EdwinKestler/2GWaterMeter/HArdware_Skecthup/README.md

# Moved

The SketchUp model now lives at [`../hardware/cad/Proyecto EmpaguaV3.skp`](../hardware/cad/Proyecto%20EmpaguaV3.skp).

This directory name was kept as a pointer so old paths and the workspace root still resolve.
