EdwinKestler/2GWaterMeter/hardware/cad/exports/README.md

# CAD exports

Put SketchUp-exported `*.stl` / `*.step` here after opening `../Proyecto EmpaguaV3.skp`. See `../README.md` for why this folder is empty: the 2014 SketchUp file cannot be converted in this environment.
