EdwinKestler/2GWaterMeter/docs/Waterbox.pdf

2 de octubre de 2017 [BUSSINESS PLAN]

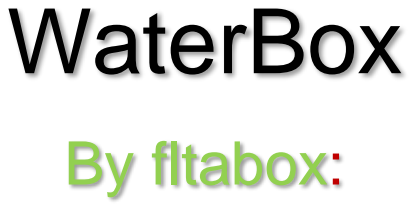
[picture p26: figure]
WaterBox; By fltabox:
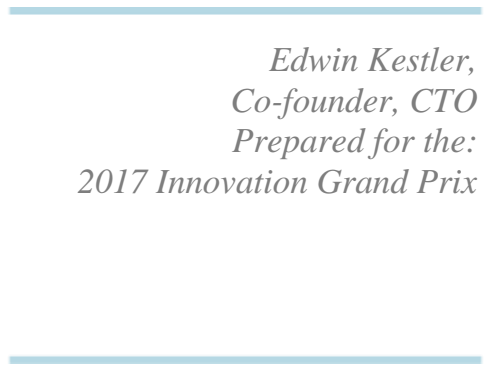
[picture p27: figure]
Edwin Kestler, Co-founder, CTO Prepared for the: 2017 Innovation Grand Prix

Flatbox, S.A | Porject: Waterbox

Flatbox, S.A | Porject: Waterbox

# index

1. Our Company
2. WaterBox
3. Why Private Utility Companies
4. Why B2B as Bussiness model
5. Estrategias de comunicación
6. Embalaje y realización
7. Estrategias de lanzamiento
8. Relaciones Públicas
9. Publicidad
10.Otras actividades promocionales 11.Precios
12.Distribución
13.Mercados
14.Mercados Internacionales 15.Indicadores de éxito
16.Calendario

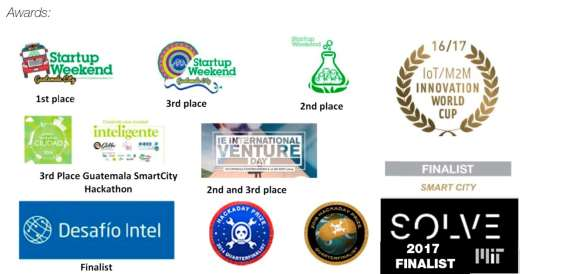
[picture p28: figure]

Flatbox, S.A | Porject: Waterbox

## Our Company

Flatbox,S.A was officially born in Sept 2015 from a group of technological enthusiasts that found a gap between how we experience our world in reality and how we represent those experiences via online data, this gap becomes most significant when using data to replicate or forecast any Bussiness process since physical world data is often incomplete, un reliable or not present at all, hence relevant insights cannot be inferred by software due to this gap in data, we fix this by building and deploying IoT enabled devices that can fill this data gap with sensor data from the conditions surrounding the business process in order to present the most relevant insights we can. As it oct 2017 we have provided solutions for various industries from Access control, via a smart bracelet and reader (15,000+ users) to Utilities with a smart water meter driven by AI (waterbox) to helatcare with a smart emergency attendace boton wich keeps Real World quality od service KPIS via RFID identification cards. (100+ devices Deployed), winning several awards including being finalist at the World mobile congress in Barcelona and MiT Solve Challenge Finalist in New York City.

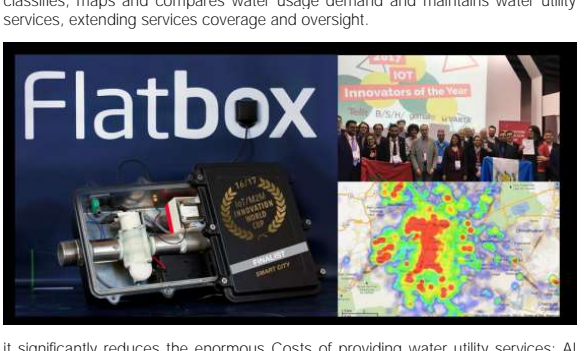
[picture p29: figure]
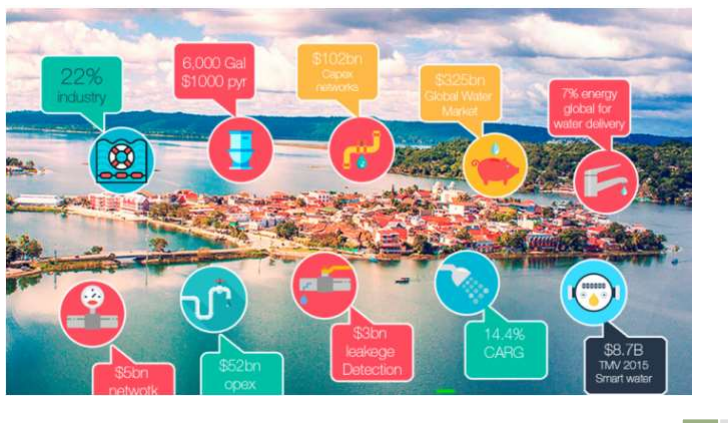
[picture p30: figure]

Flatbox, S.A | Porject: Waterbox

## WaterBox

Waterbox is a 2G IoT, AI managed autonomous Water Meter, it acquired, classifies, maps and compares water usage demand and maintains water utility services, extending services coverage and oversight.

it significantly reduces the enormous Costs of providing water utility services; AI handles data acquired, classifies, maps and compares water usage demand, assigns billing profiles, uses machine learning to maintain the service, autonomously analyzing sensor data a self-recharging mechanism, pressure, tamper and other sensors prevent water fraud and report potential problems such as leaks in the network without human supervision and its cost;

Designed to meet demands for House hold, Small and Medium Business Utilities it enables new pricing models and payment (SMS,Mobile, POS) to be introduced, such as PAYG, prepaid, and other for low income or remote rural areas.

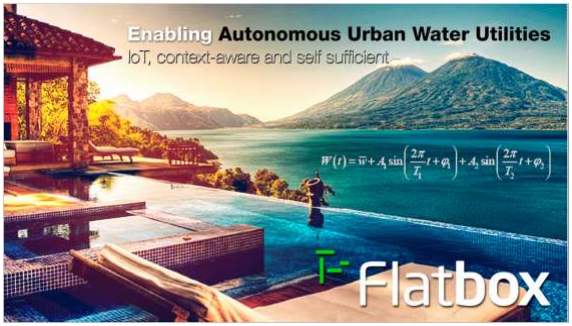
[picture p31: figure]

Flatbox, S.A | Porject: Waterbox

## Watch our pitch @World Mobile Congress 2017:

https://www.youtube.com/watch?v=Ffp5oGQv2uI

it significantly reduces the enormous Costs of providing water utility services; AI handles data acquired, classifies, maps and compares water usage demand, assigns billing profiles, uses machine learning to maintain the service, autonomously analyzing sensor data a self-recharging mechanism,pressure, tamper and other sensors prevent water fraud and report potential problems such as leaks in the network without human supervision and its cost; Designed to meet demands for House hold, Small and Medium Business Utilities it enables new pricing models and payment (SMS,Mobile, POS) to be introduced, such as

PAYG, prepaid, and other for low income or remote rural areas. Bringing transparency, control and flexibility of consumption to utility services increased increased 15% of reliability of utility services and Better water management and monitoring results in a better usage of the resource service preventing scarcity and misuse, providing transparency and efficiency in the utility service, deployment will be done by user adoption (purchase) of the devices driven by reduced water fees incentives via reduction on first water usage data.

It also gives Utility services a way to actively engage service users into

conservation plans such as alert Emails and SMS on misuse, over use or Threshold, every meter generates a water usage signature from machine learning
which is compared continuously to ensure | on service are met and I
incase of severe modification autonomous actions can be taken by the meter in order to prevent significant losses of the resource due to faults or client missuses.

so far we have been granted seed funds from a nonrefundable grant price from a local NGO by the embassy of Taiwan; have a functioning and tested prototype and already have a letter of intent by a private water utility service provider for deploying a 1000 household solution in a 15 year bid to install them in el Fiscal community outside of Guatemala city; to deploy our pilot program a $USD150,000 investment is still needed, upon completion of first pilot program we plan on seeking funding from investors to expand the services in urban areas of Guatemala (private gated house compounds) about 1Million households in Guatemala and from there make the project self-sufficient to expand to rural areas, and seeking VC funds for international growth (about 18 month plan)

The factors limiting our success:

The actual make of the device, as any other IoT project the actual front cost of making the devices is our major growth limit, as it for now our device has a net cost $USD100; as increasing numbers changes costs and time tables for delivery of the devices, making, shipping and delivering the devices is our biggest logistics challenge.
How long we have been working on our solution:
1 year
How long it will take to develop a pilot:
3-6 months
How long it will take to scale beyond our pilot: 6-12 months
Our expected annual budget:
$150000
How much of our budget we've secured to date: $50000

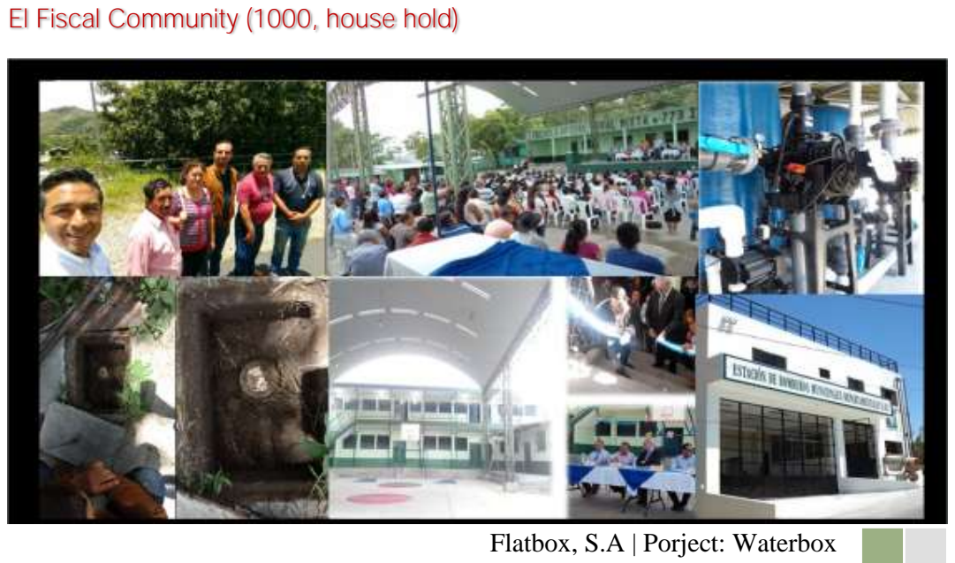
[picture p32: figure]
Flatbox, S.A | Porject: Waterbox; El Fiscal Community (1000, house hold)
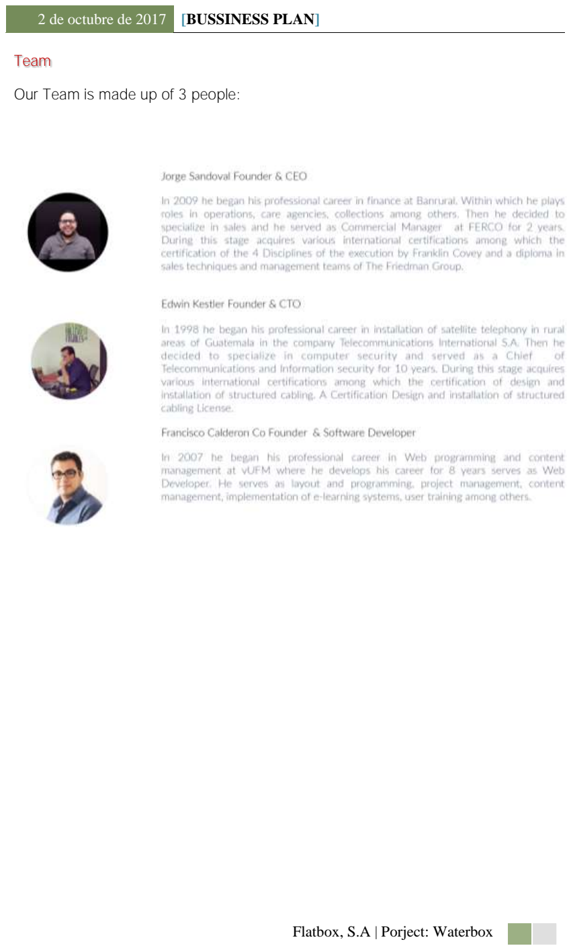
[picture p33: page 7]

Flatbox, S.A | Porject: Waterbox

Team

Our Team is made up of 3 people:

Flatbox, S.A | Porject: Waterbox

## Calendario

Señale el cronograma de actividades en los primeros 12 meses.
