EdwinKestler/2GWaterMeter/docs/WaterBox-EdwinKestler-09-06-2017.pdf

## Enabling, Autonomous Urban Water Utilities

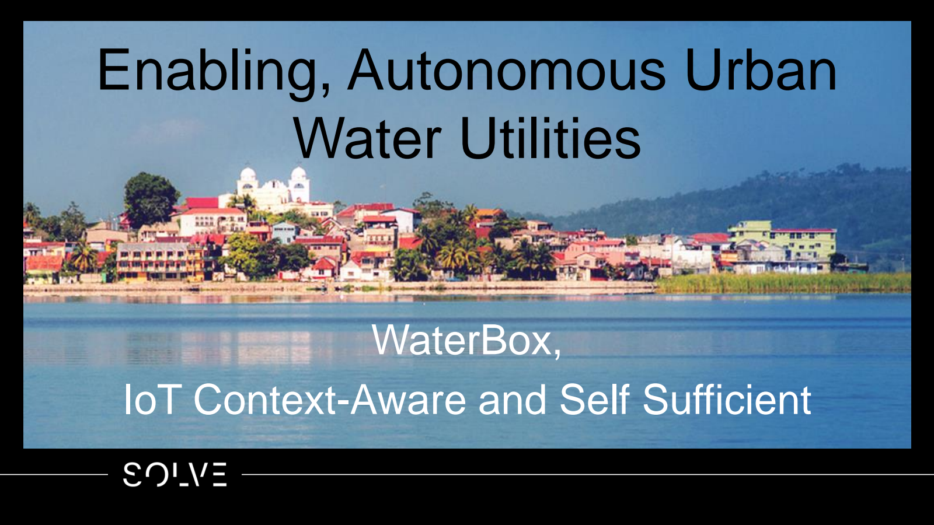
[picture p34: page 1]

WaterBox,
IoT Context-Aware and Self Sufficient

## Great Slides Don’t Need Words

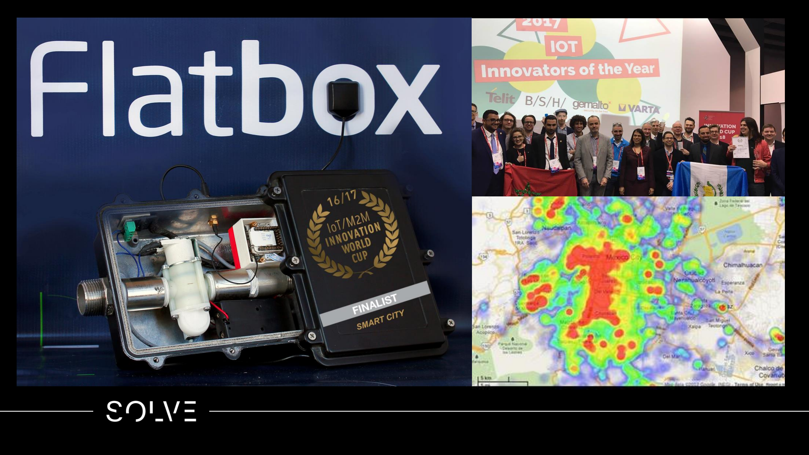
[picture p35: page 2]

Full-page images are very impactful (see next slide).

People understand that images represent what you’re saying; there is no need to describe the images.

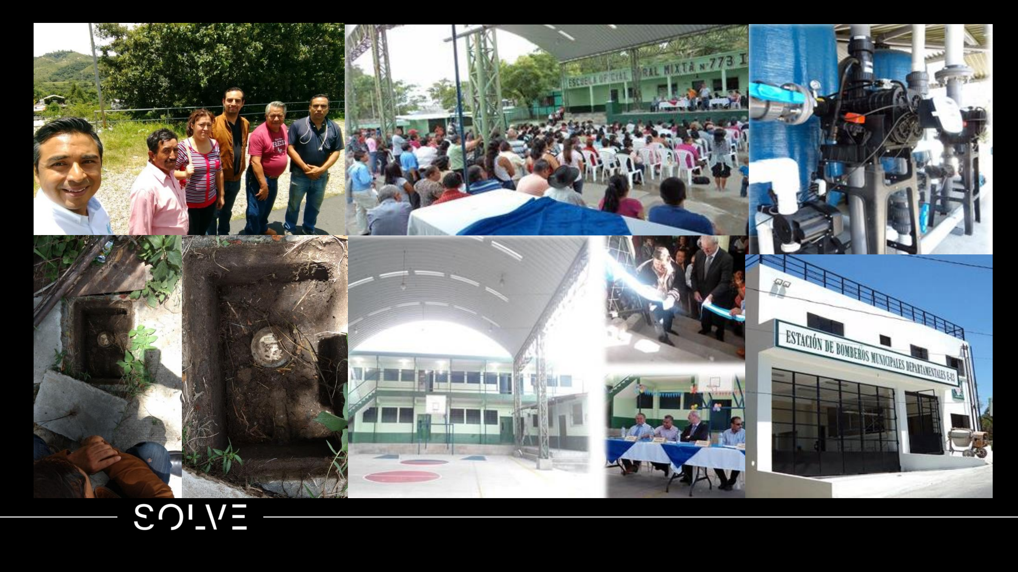
[picture p36: page 3]
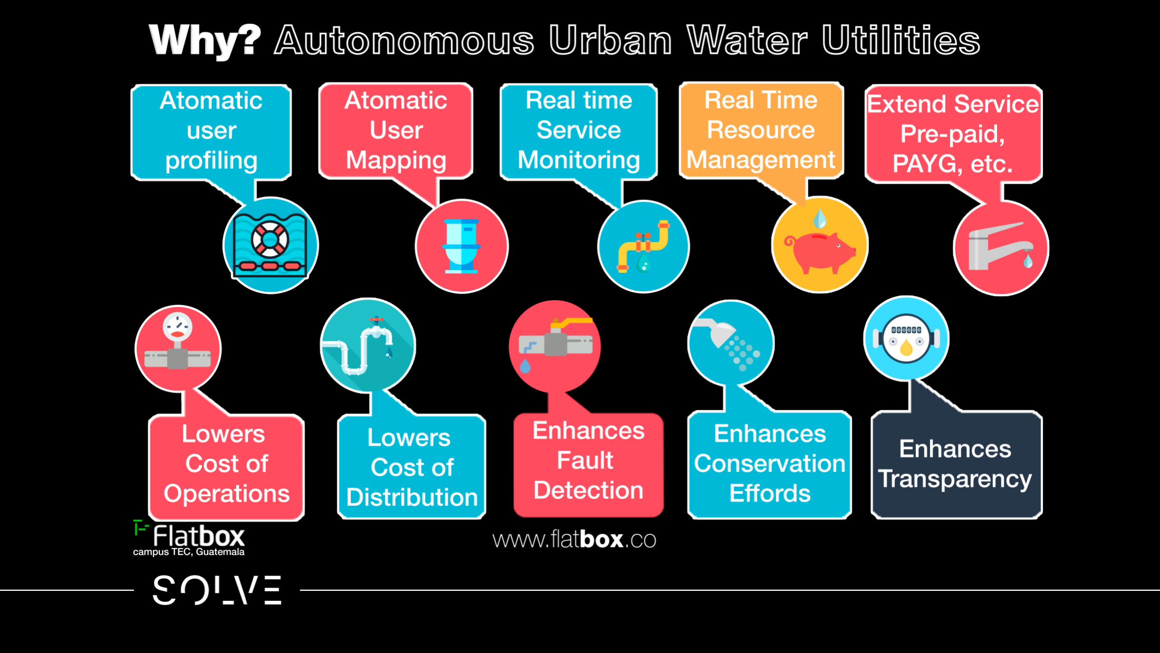
[picture p37: page 4]
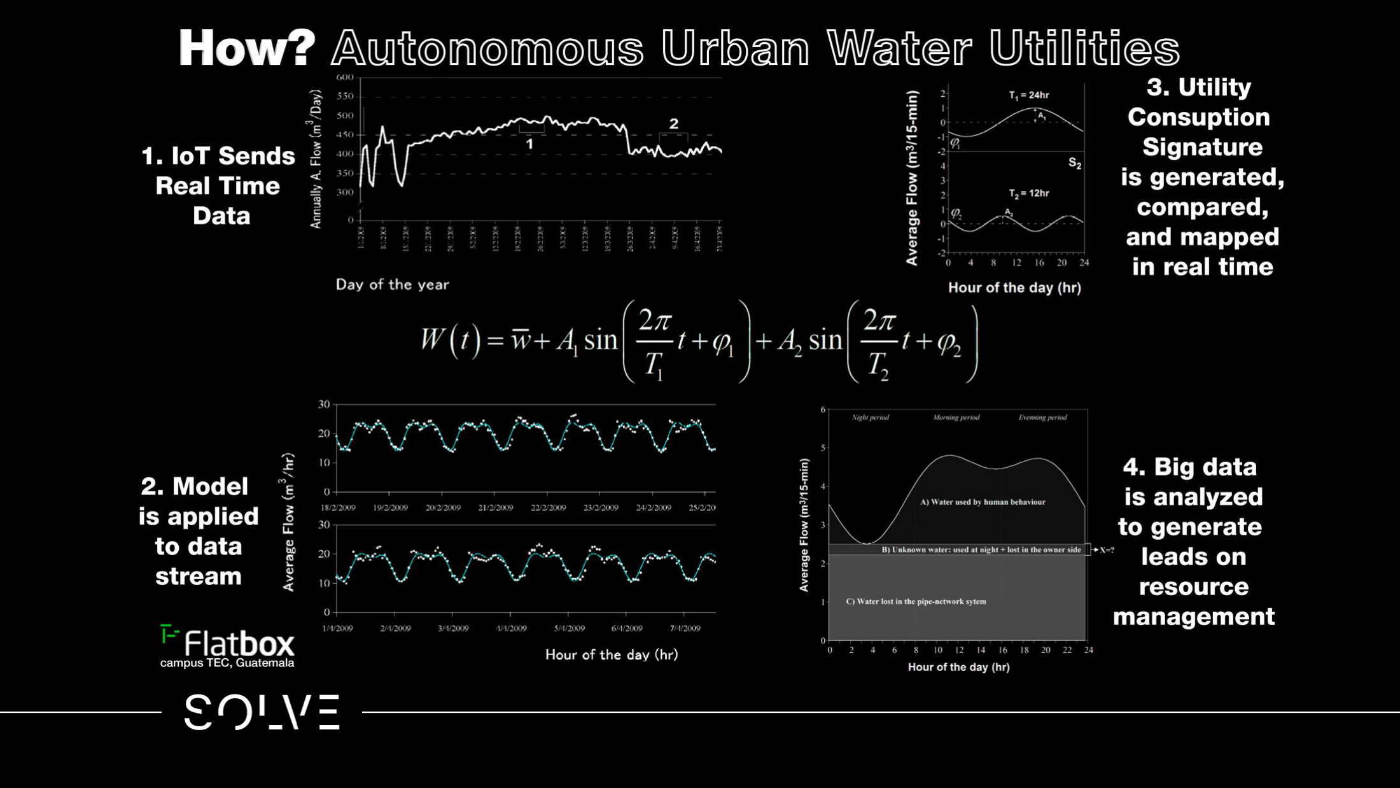
[picture p38: page 5]
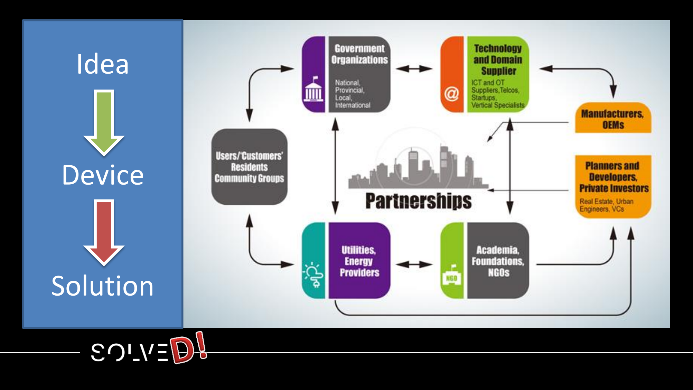
[picture p39: page 6]

Idea

Device

Solution
