EdwinKestler/2GWaterMeter/docs/Waterbox intro.png

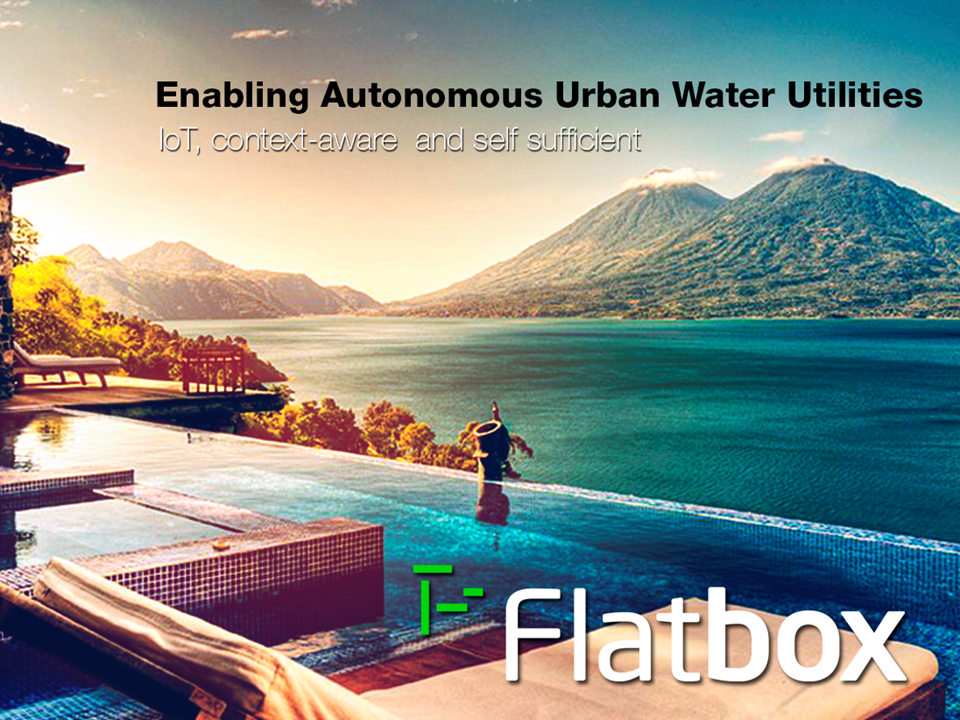
docs/Waterbox intro.png
