EdwinKestler/2GWaterMeter/docs/WATERBOX_960.png

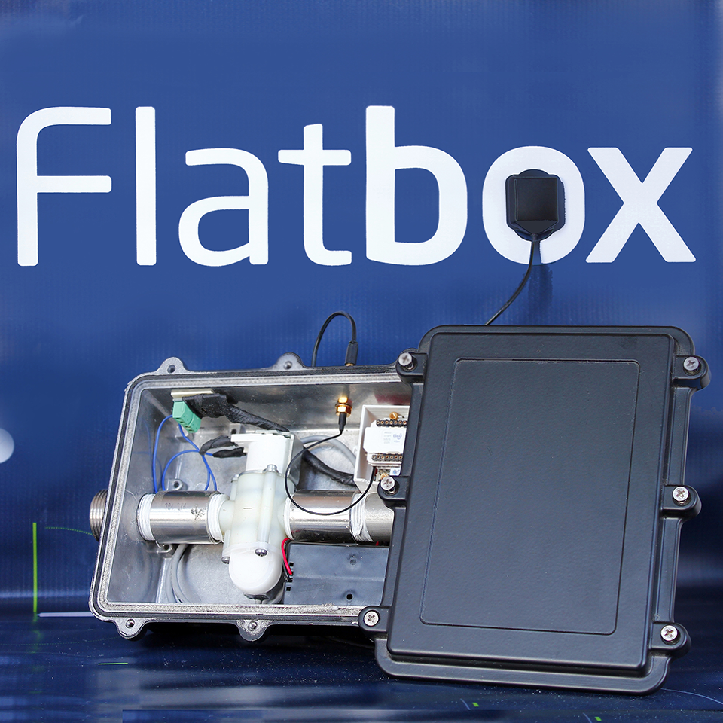
docs/WATERBOX_960.png
