EdwinKestler/2GWaterMeter/docs/WATERBOX_finalist.png

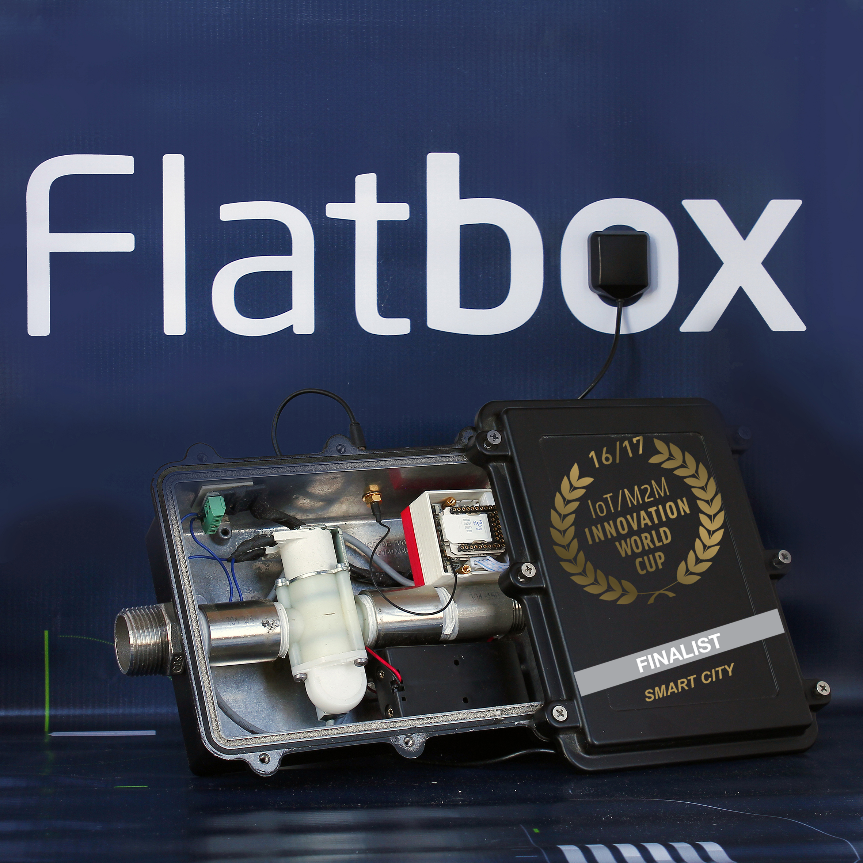
docs/WATERBOX_finalist.png
