EdwinKestler/2GWaterMeter/docs/Waterboxproblems.png

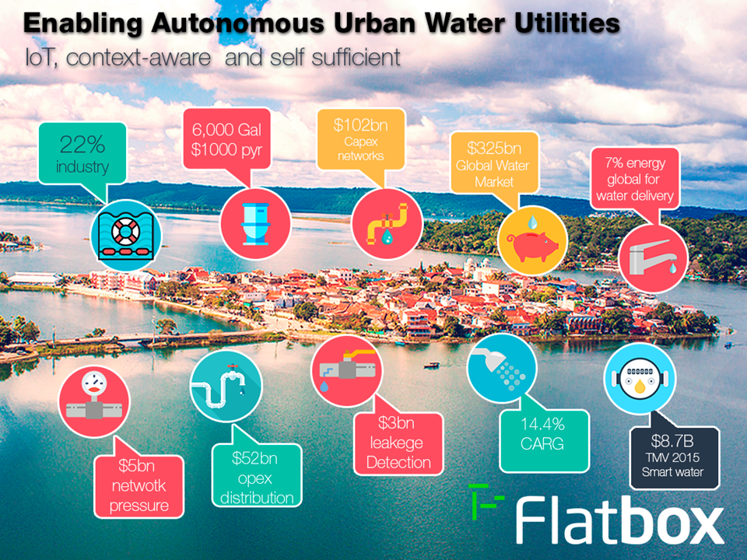
docs/Waterboxproblems.png
