EdwinKestler/2GWaterMeter/hardware/photos/20160726_220433.jpg

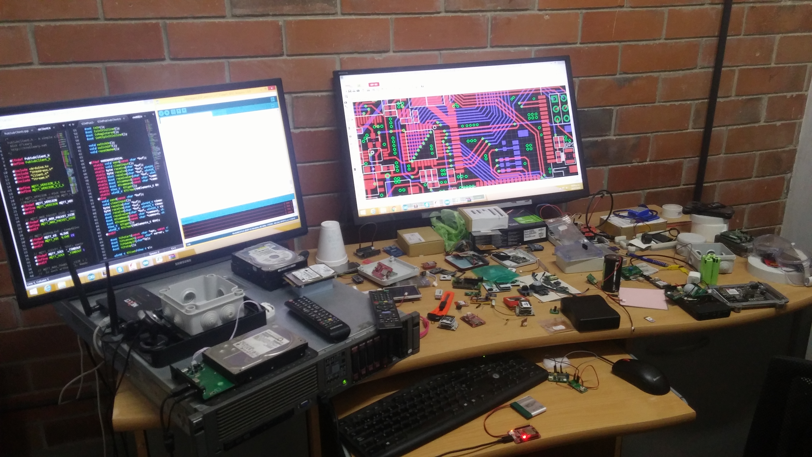
hardware/photos/20160726_220433.jpg
