EdwinKestler/2GWaterMeter/hardware/photos/20160727_200548.jpg

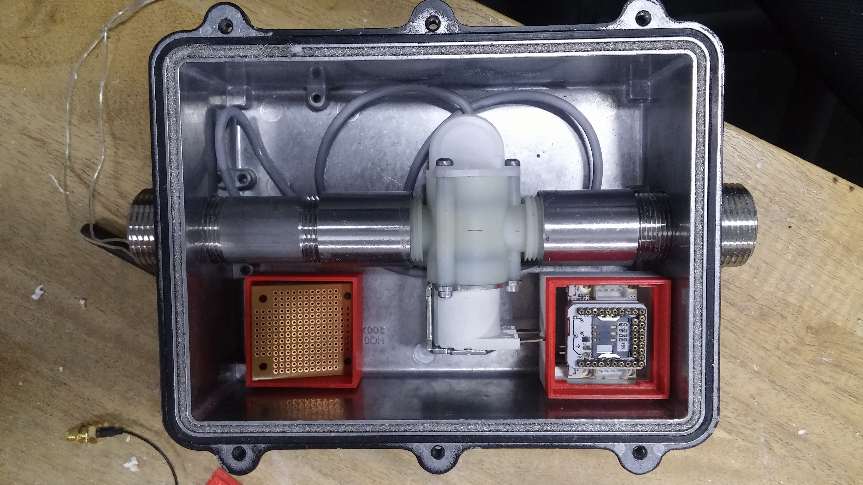
hardware/photos/20160727_200548.jpg
