EdwinKestler/2GWaterMeter/hardware/photos/20160727_200815.jpg

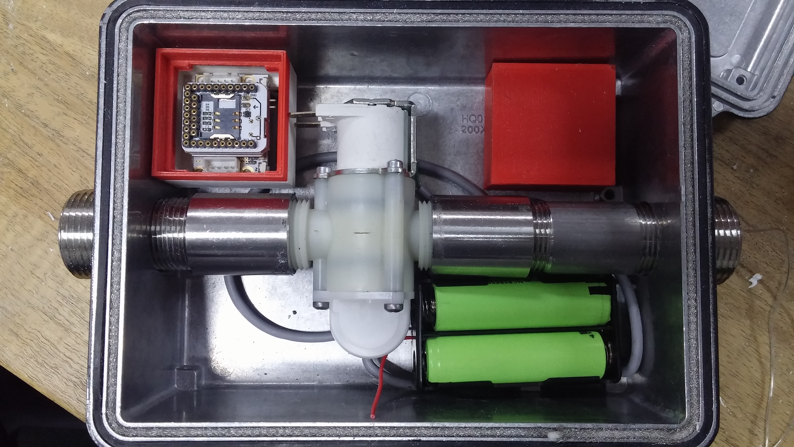
hardware/photos/20160727_200815.jpg
