EdwinKestler/2GWaterMeter/hardware/photos/20160727_200831.jpg

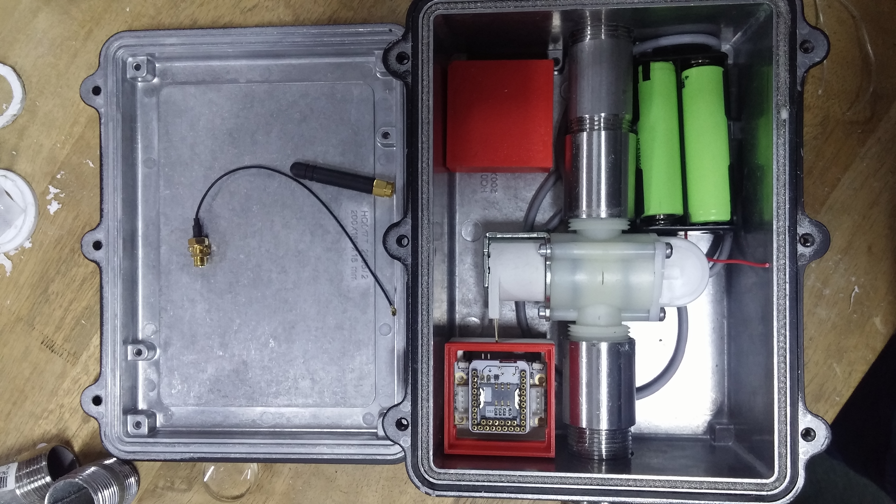
hardware/photos/20160727_200831.jpg
