EdwinKestler/2GWaterMeter/hardware/photos/20160727_200846.jpg

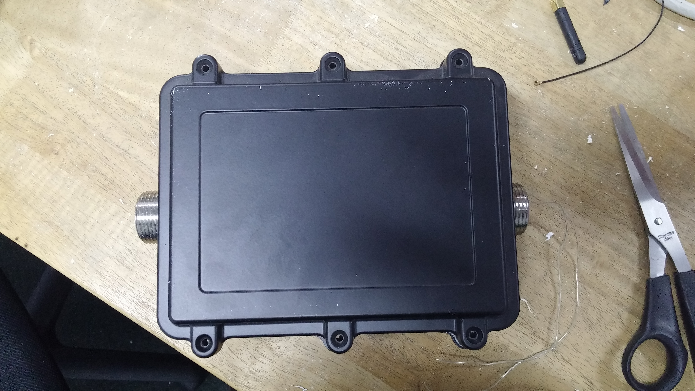
hardware/photos/20160727_200846.jpg
