EdwinKestler/2GWaterMeter/hardware/photos/20160728_052809.jpg

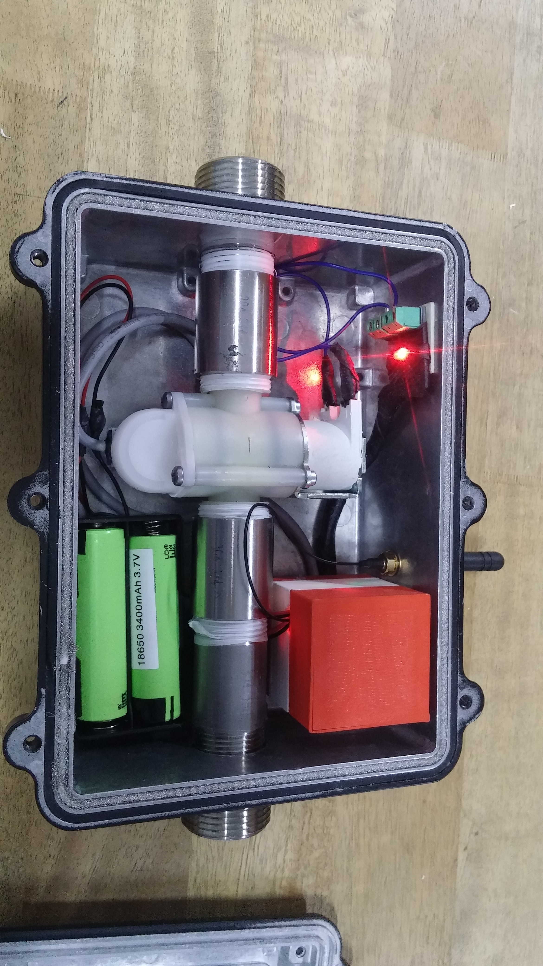
hardware/photos/20160728_052809.jpg
