EdwinKestler/2GWaterMeter/hardware/photos/20160728_053938.jpg

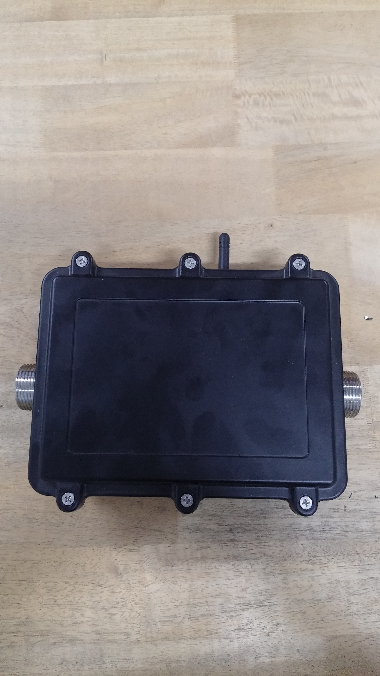
hardware/photos/20160728_053938.jpg
