EdwinKestler/2GWaterMeter/hardware/photos/20160728_053944.jpg

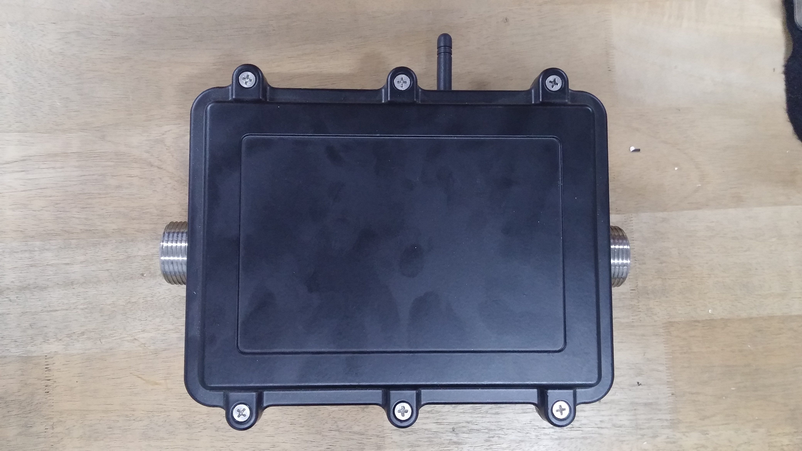
hardware/photos/20160728_053944.jpg
