EdwinKestler/2GWaterMeter/hardware/photos/HCMIDU0002_Versions.png

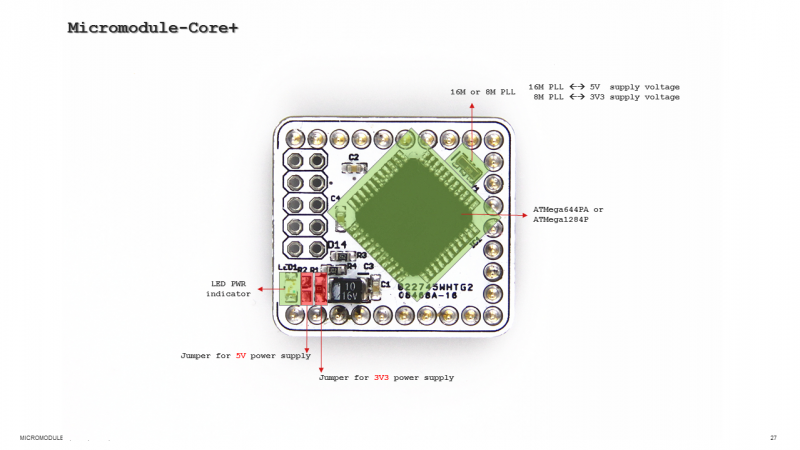
hardware/photos/HCMIDU0002_Versions.png
