EdwinKestler/2GWaterMeter/hardware/renders/Captura5Valvula.png

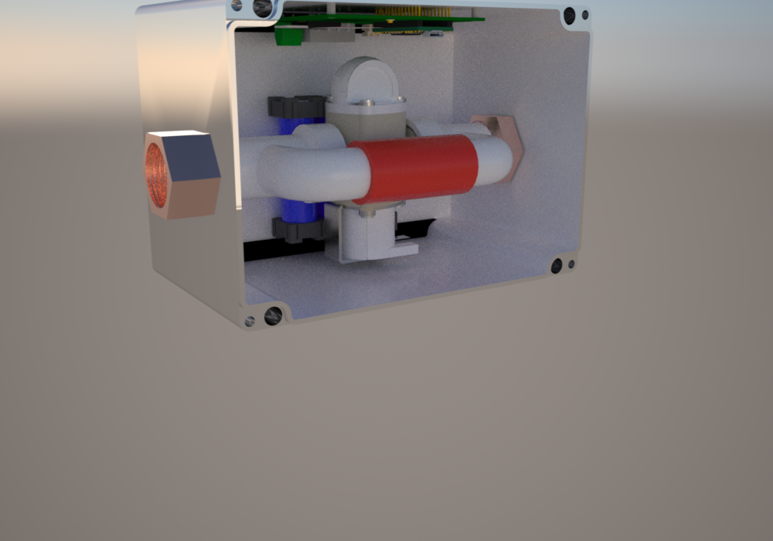
hardware/renders/Captura5Valvula.png
