EdwinKestler/2GWaterMeter/hardware/renders/Captura7GValvula.png

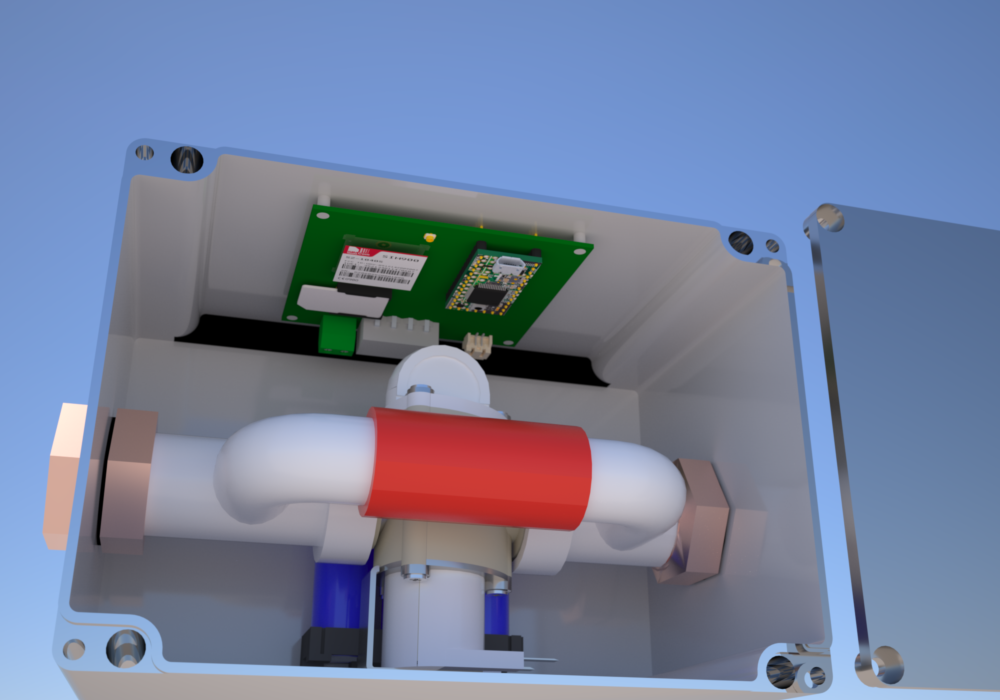
hardware/renders/Captura7GValvula.png
