EdwinKestler/2GWaterMeter/hardware/schematics/Microduino-Core+/PCB_b.png

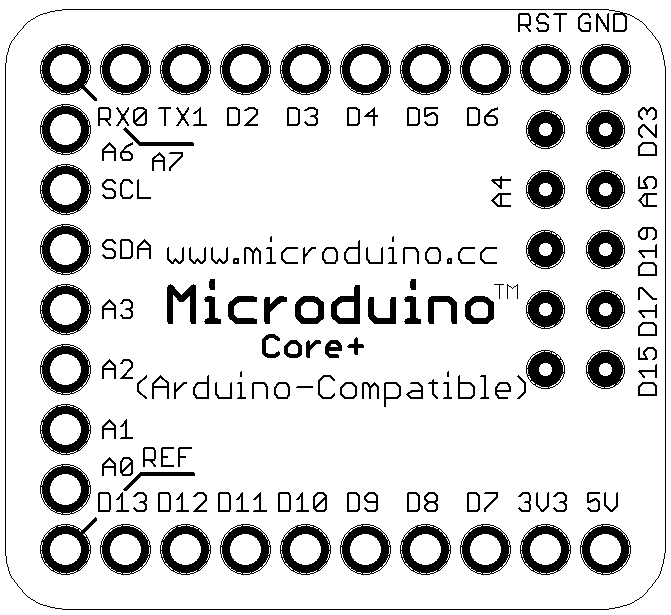
hardware/schematics/Microduino-Core+/PCB_b.png
