EdwinKestler/2GWaterMeter/hardware/schematics/Microduino-Core+/PCB_t.png

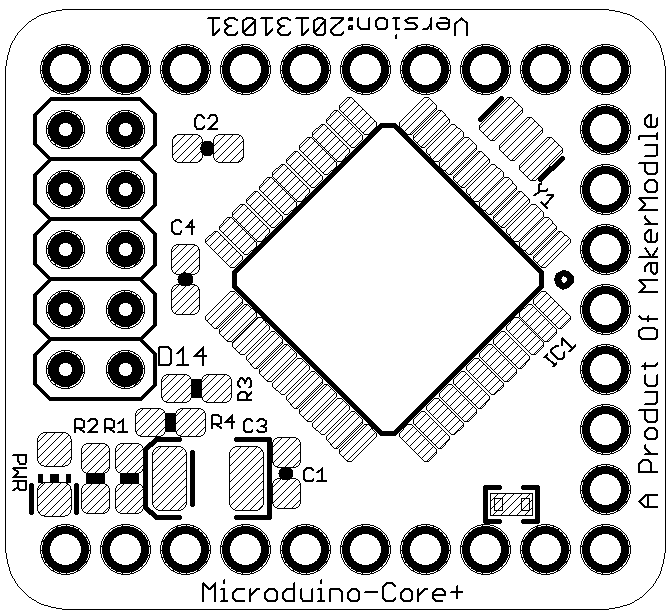
hardware/schematics/Microduino-Core+/PCB_t.png
