EdwinKestler/2GWaterMeter/hardware/schematics/Microduino-GSMShield/Microduinio GSM-SIM800-b.png

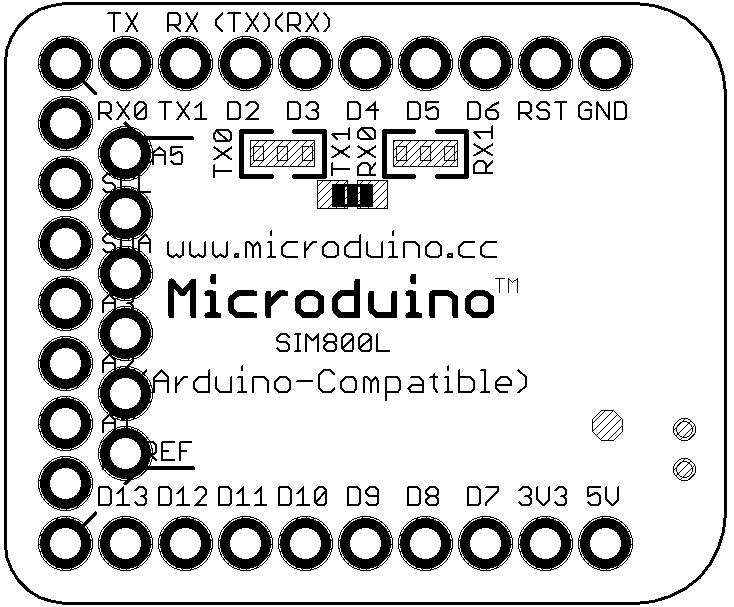
hardware/schematics/Microduino-GSMShield/Microduinio GSM-SIM800-b.png
