EdwinKestler/2GWaterMeter/hardware/schematics/Microduino-GSMShield/Microduinio GSM-SIM800-t.png

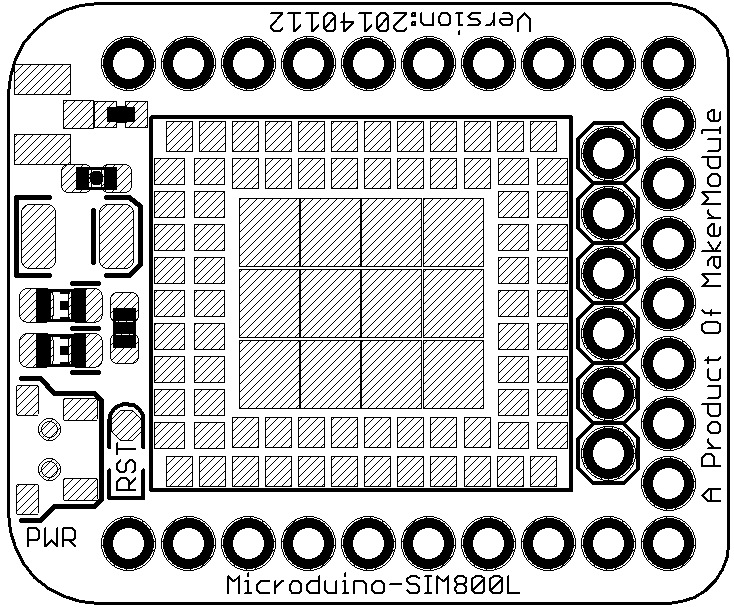
hardware/schematics/Microduino-GSMShield/Microduinio GSM-SIM800-t.png
