EdwinKestler/2GWaterMeter/hardware/schematics/Microduino-GSMShield/Microduino-SIM-Shield-b.png

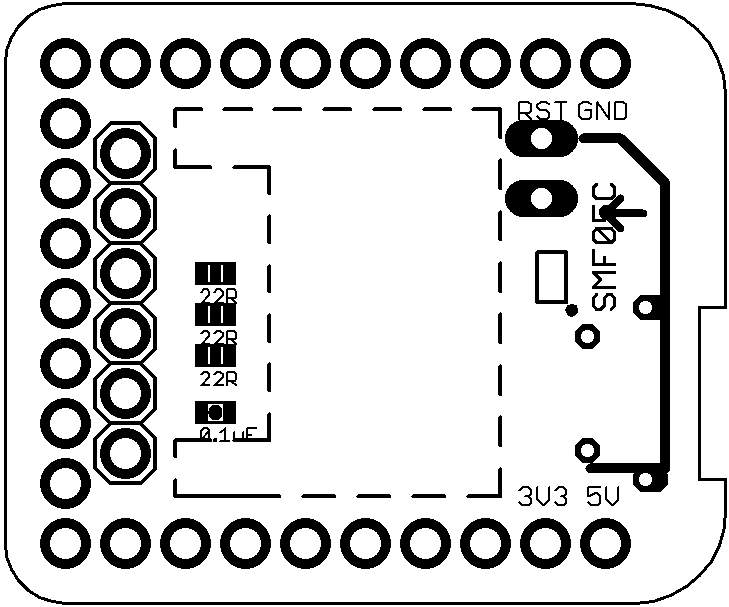
hardware/schematics/Microduino-GSMShield/Microduino-SIM-Shield-b.png
