EdwinKestler/2GWaterMeter/hardware/schematics/Microduino-GSMShield/Microduino-SIM-Shield-t.png

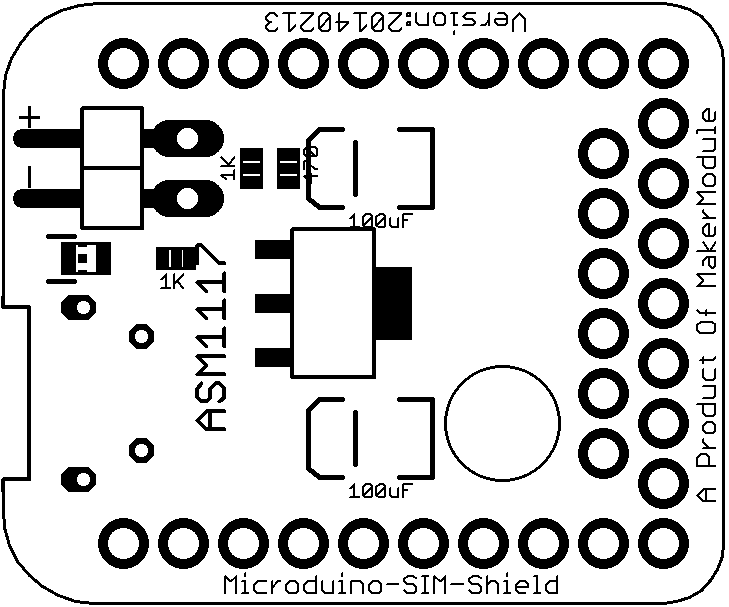
hardware/schematics/Microduino-GSMShield/Microduino-SIM-Shield-t.png
