EdwinKestler/2GWaterMeter/(list of files, cad)

Other CAD files:
hardware/cad/Proyecto EmpaguaV3.skp
