EdwinKestler/2GWaterMeter/docs/TestBox_view3.JPG

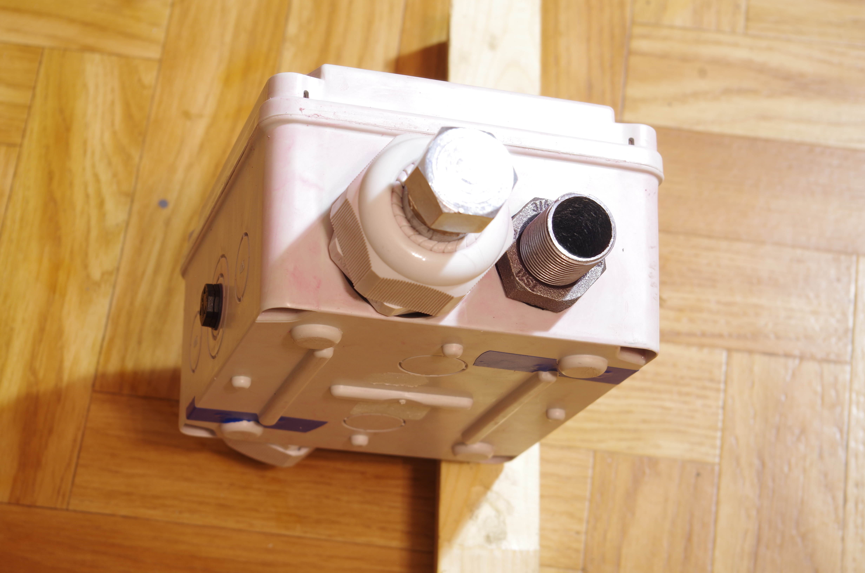
docs/TestBox_view3.JPG
