EdwinKestler/2GWaterMeter/docs/Enclosure assembly V-02.pdf

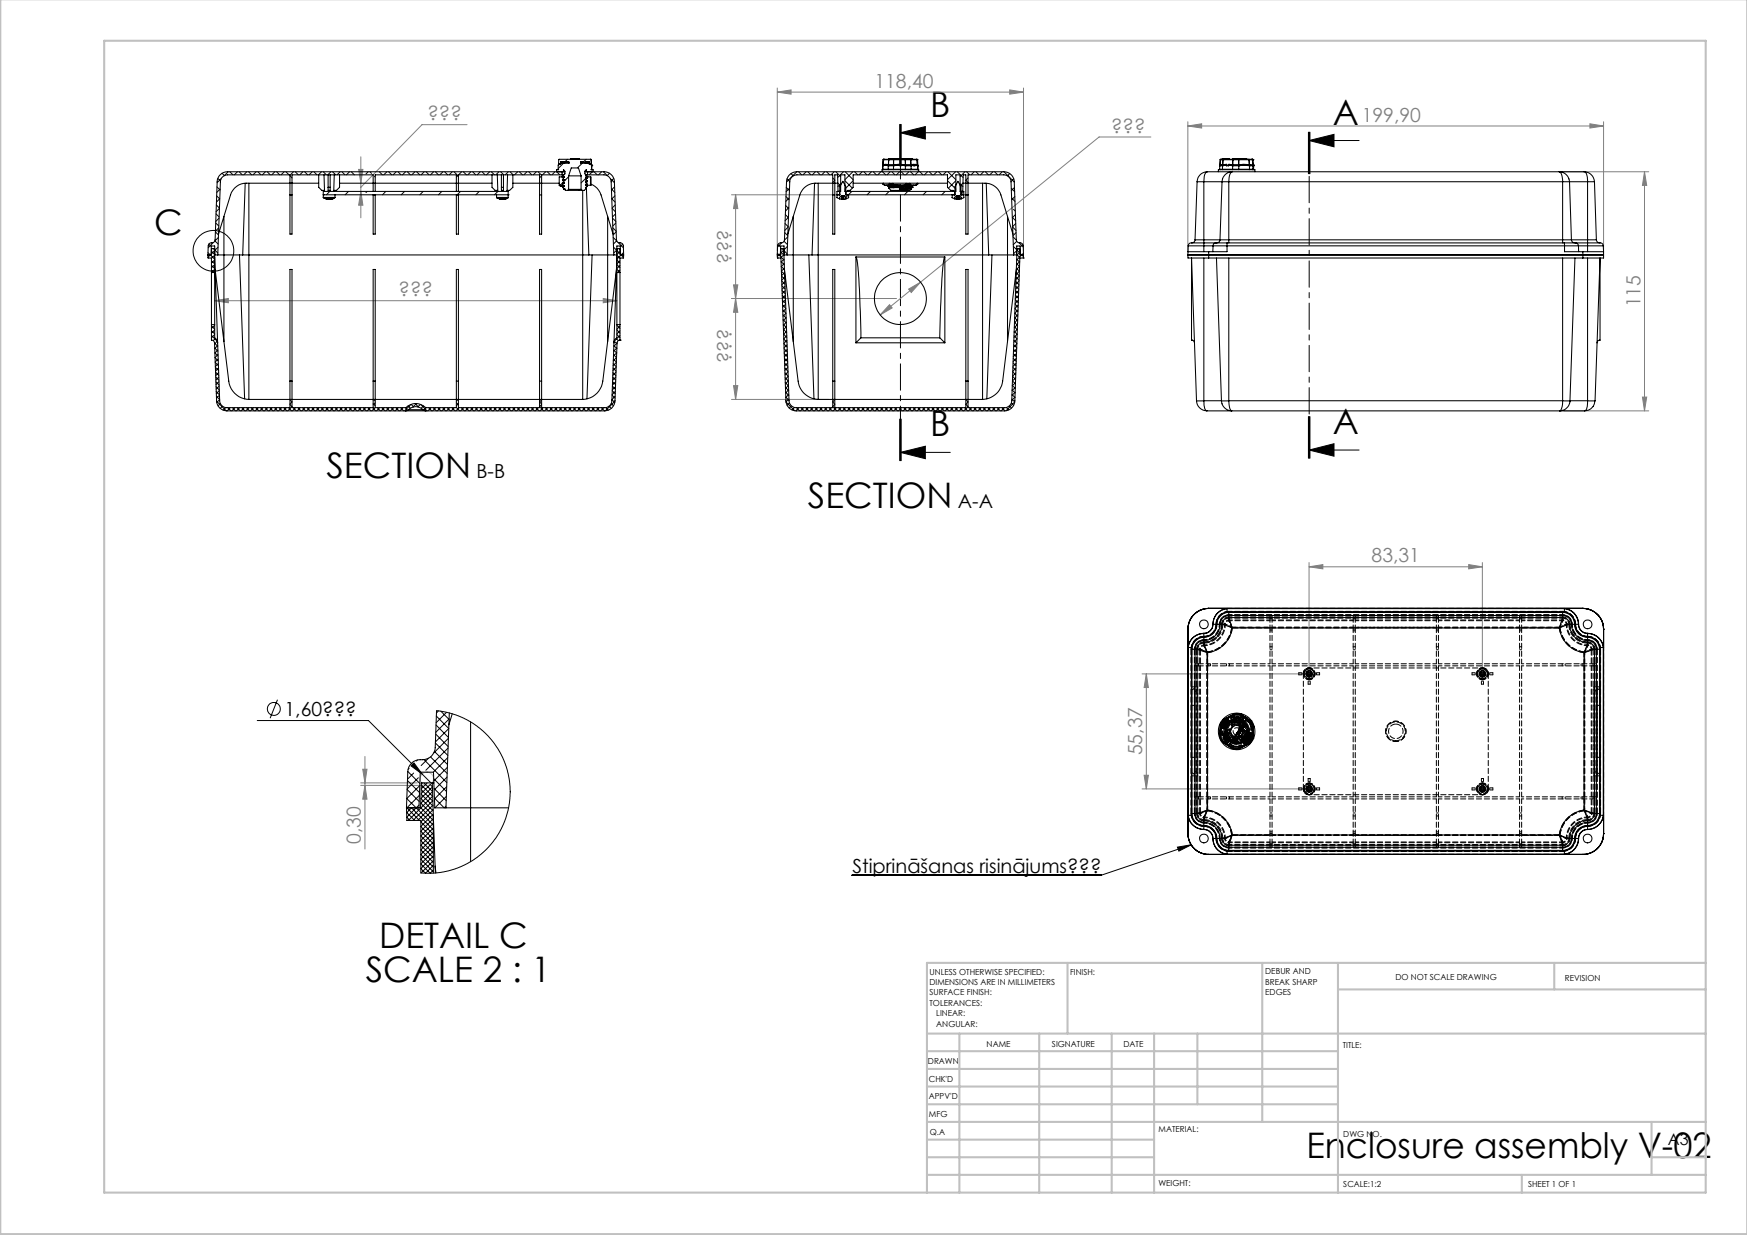
[picture p62: page 1]
SECTION A-A; SECTION B-B; Stiprināšanas risinājums???; DETAIL C SCALE 2 : 1; SCALE:1:2; SHEET 1 OF 1; DO NOT SCALE DRAWING; REVISION; DEBUR AND BREAK SHARP; UNLESS OTHERWISE SPECIFIED:; FINISH:

DIMENSIONS ARE IN MILLIMETERS
SURFACE FINISH:
TOLERANCES:
LINEAR:
ANGULAR:

NAME | SIGNATURE | DATE | | | | TITLE:
Q.A | | | | MATERIAL: Enclosure assembly V-02 WEIGHT: | DWG NO. | A3

DRAWN
CHK'D
APPV'D
MFG
