EdwinKestler/2GWaterMeter/firmware/waterbox/settings.h

#ifndef WATERBOX_SETTINGS_H
#define WATERBOX_SETTINGS_H

// Network (Tigo Guatemala 2G M2M). Confirm the APN with the carrier before
// field use; 2G is end-of-life in many markets — see docs/2G-EOL.md.
#define GSMAPN "m2mgt.tigo.com"
#define GSMUSER ""
#define GSMPASSWORD ""

// LAN IP or hostname of the machine running docker compose (RabbitMQ :1883).
const char mqttServer[] = "192.168.1.10";
const uint16_t mqttPort = 1883;

// Matches docker/.env.example MQTT_USER / MQTT_PASS (one-house lab).
const char mqttUser[] = "waterbox";
const char mqttPass[] = "waterbox";
#define MQTT_ALLOW_ANONYMOUS 0

// Topics are built as waterbox/<IMEI>/{data,cmd,info} after the modem reports IMEI.
#define TOPIC_ROOT "waterbox"

// RPE BVS_RF-3-30L: 245 pulses/litre Hall (black JST), 490 Reed (white JST).
// Set to 1 if the installed pickup is Reed.
#define FLOW_SENSOR_REED 0
#define PULSES_PER_LITER_HALL 245
#define PULSES_PER_LITER_REED 490

// Microduino Core+: Serial1 on D2/D3 (SIM800), PWM on D9/D10 (L9110),
// external interrupts on D2, D3, and D6. D6 is the only free INT pin.
#define PIN_VALVE_IA 9
#define PIN_VALVE_IB 10
#define PIN_FLOW 6
#define PIN_SIM_PWR 5
#define PIN_SIM_RST 7
#define PIN_STATUS_LED 13

// RPE latching L6V coil is specified at 25 ms. Holding (100% ED) coils need a
// longer pulse plus a hold voltage — do not use this value for those SKUs.
#define VALVE_PULSE_MS 25
#define VALVE_SPEED 255

#define PUBLISH_INTERVAL_MS 60000UL
#define HEARTBEAT_INTERVAL_MS 3600000UL
#define CMD_LISTEN_MS 8000UL
#define RADIO_RETRY_MAX 3
#define RADIO_RETRY_DELAY_MS 2000UL
#define SIM_INIT_TRIES 10
#define SIM_RETRY_MS 30000UL
#define FLOW_SAMPLE_MS 1000UL
#define EEPROM_SAVE_MS 60000UL
#define SERIAL_BAUD 57600

// Slide model: W(t) = w + A1 sin(2π t/T1 + φ1) + A2 sin(2π t/T2 + φ2)
// t = hour of day. T1 = 24 h (daily), T2 = 12 h (twice-daily). Units: L/min.
#define SIG_T1_H 24.0f
#define SIG_T2_H 12.0f
#define SIG_NIGHT_START_H 0.0f
#define SIG_NIGHT_END_H 5.0f
#define SIG_LEAK_MARGIN_LM 0.15f
#define SIG_OVER_MARGIN_LM 0.50f
#define SIG_FLOW_FLOOR_LM 0.05f

#endif
