EdwinKestler/2GWaterMeter/(commit log)

2016-08-02 First upload of Project
    All work done so far for the las 6 moths and a half... F*ck its a lot!
    [Microduino-Core+.sch, Microduino-SIM-Shield 20140213.sch, Microduino-SIM800H 20140112.sch]
2026-09-18 update code
    [Microduino-Core+.sch, Microduino-SIM-Shield 20140213.sch, Microduino-SIM800H 20140112.sch, Proyecto EmpaguaV3.skp]
2026-09-18 Add cloud stack, household portal, and meter fingerprint loop.
    Firmware evaluates a cloud-fitted two-harmonic usage model, accepts per-IMEI valve and fingerprint MQTT, and publishes hourly health. Compose runs RabbitMQ MQTT, Postgres, the worker, Grafana, and the Next.js portal on one database for a single-house lab.
2026-09-18 Add a GitHub Pages technical site assembled from docs assets.
    Static HTML in website/ is published by Actions from diagrams, illustrations, and hardware photos. Replaces the stock Next.js Pages workflow, which did not match this repo.
2026-09-18 Add remaining docs PDFs, slides, and Photoshop sources.
    Enclosure drawings, MIT Solve overview, and WATERBOX art files that were still untracked.
2026-09-19 Rebuild the Pages site in the Industry blueprint design system
    Replaces the dark site.css palette with a light "technical instrument"
    look across all seven pages, implementing the Claude Design mockups
    (home, fingerprint, hardware, and the 390 px mobile treatment) and
    carrying the same grammar to goal, firmware, cloud and portal.
    - css/industry.css: the Industry design system, verbatim. Tokens plus
    .blueprint/.corner, .card, .btn, .table, .nav, .tag, .duotone.
    - css/site.css: rewritten as a thin site layer over it — page shell,
    hero, spec plate, fingerprint instrument chart, live-state animations
    and the responsive rules. No token is redefined here.
    - All pages: registration-marked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
2026-09-19 Bake Compose images and add a DAIAD MQTT replay for local lab tests.
    RabbitMQ, Postgres, and Grafana configs are copied into images so Docker Desktop does not need /mnt bind mounts. Postgres is published on host 5433. tools/simulate_mqtt.py replays public meter CSVs onto waterbox topics; fit_once publishes fingerprints.
2026-09-19 Restyle the household portal to the Industry blueprint used on Pages.
    Barlow fonts, paper/ink/accent tokens, registration-mark frames, and matching Recharts/map colors so localhost:3001 reads like the GitHub documentation site.
